dvwiebe/ADS1220RTD_Brewno_V2_Hardware/README.md

# ADS1220RTD_Brewno_V2_Hardware
RTD Shield Hardware
All the files you need to build your own shield.  The Gerber Files and Excellon drill file included to allow you to go straight
to fabrication.  Alternatively the Eagle files are available.
