dvwiebe/ADS1220RTD_Brewno_V2_Hardware/ADS1220RTD_BREWNO_V2_BOM.xlsx

 | Part
PCB Label | Qty | Device Description | Package | Value | Part# | Unit Cost | Extended Cost | Comments
ADS1220 | 1 | ADS1220 Temperature IC | TSSOP16 |  | ADS1220IPW | $14.65 | $14.65
PIC16F18345 | 1 | PDIP20 SOCKET | DIL20 |  | 4820-3004-CP | $0.88 | $0.88
ICSP | 1 | PINHD-1X5 | 1X05 |  | 22284101 | $0.55 | $0.55
DIGITAL8_13 | 1 | Pin Header 0.1" Pitch, 0.32" Mating Length | 1X10 |  | 22284101 | $0.74 | $0.74 | Optional if you cannot find Arduino Male & Female Header Pins. These work find but you cannot stack additional shields and you cannot breadboard easily with the shield attached.
ANALOG0_5 | 1 | Pin Header 0.1" Pitch, 0.32" Mating Length | 1X06 |  | 22284121 | $0.89 | $0.89
DIGITAL0_7, POWER | 2 | Pin Header 0.1" Pitch, 0.32" Mating Length | 1X08 |  | 22284081 | $0.61 | $1.22
Arduino Header Pin Set | 1 | Set of Arduino Header Pins w/ Male and Female Ends |  |  | PRT-11417 | $2.16 | $2.16 | Preferred. These can sometimes be harder to find but allow stacking of multiple shields
C2_5V, C3_5V, C4_5V, C15V | 4 | CAPACITOR- X7R or better | C0603 | 0.1uF | GRM188R71C104JA01D | $0.16 | $0.64
R1_5V | 1 | RESISTOR - 25ppm/C or better | R0603 | 10 ohms | RT0603DRD0710RL | $0.18 | $0.18
R1MCLR, R1_SW, R2_SW | 3 | RESISTOR | R0603 | 10Kohms | RC0603JR-0710KL | $0.02 | $0.06
C5_5V | 1 | CAPACITOR | C0603 | 10uF | GRM188R61A106ME69D | $0.26 | $0.26
RTD Terminals | 1 | SCREW TERMINAL |  |  | 1751345 | $9.31 | $9.31
RREF | 1 | RESISTOR - 10ppm/C or better | R0603 | 2.49Kohms | TNPU06032K49BZEN00 | $3.60 | $3.60
R1I2C, R2I2C | 2 | RESISTOR | R0603 | 4.7Kohms | RC0603JR-074K7L | $0.02 | $0.04
RF3, RF4 | 2 | RESISTOR - 25ppm/C or better | R0603 | 4.7kohms | AT0603DRD074K7L | $0.20 | $0.40
CCM1, CCM2, CCM3, CCM4 | 4 | C-EUC0603 | C0603 | 4.7nF | C0603C472J5GACTU | $0.45 | $1.80
R1SPI, R2SPI, R3SPI, R4SPI, R5SPI | 5 | RESISTOR | R0603 | 47 ohms | RC0603JR-0747RL | $0.02 | $0.10
RF1, RF2 | 2 | RESISTOR - 25ppm/C or better | R0603 | 5.9Kohms | RT0603DRD075K9L | $0.34 | $0.68
CDIF1, CDIF2 | 2 | RESISTOR - C0G/NPO | C1206 | 51nF | GRM31M5C1H513JA01L | $0.98 | $1.96
MAX4618CSE | 1 | IC SWITCH | SO16 |  | MAX4618CSE | $2.47 | $2.47
PIC16F18345 | 1 | PIC MICROCONTROLLER | PDIP20 |  | PIC16F18345-I/P | $2.01 | $2.01
 |  |  |  |  |  | Total | $41.75
