dvwiebe/ADS1220RTD_Brewno_V2_Hardware/ADS1220RTD_BREWNO_V2.brd

## EAGLE design ADS1220RTD_BREWNO_V2.brd (2016-12-25)

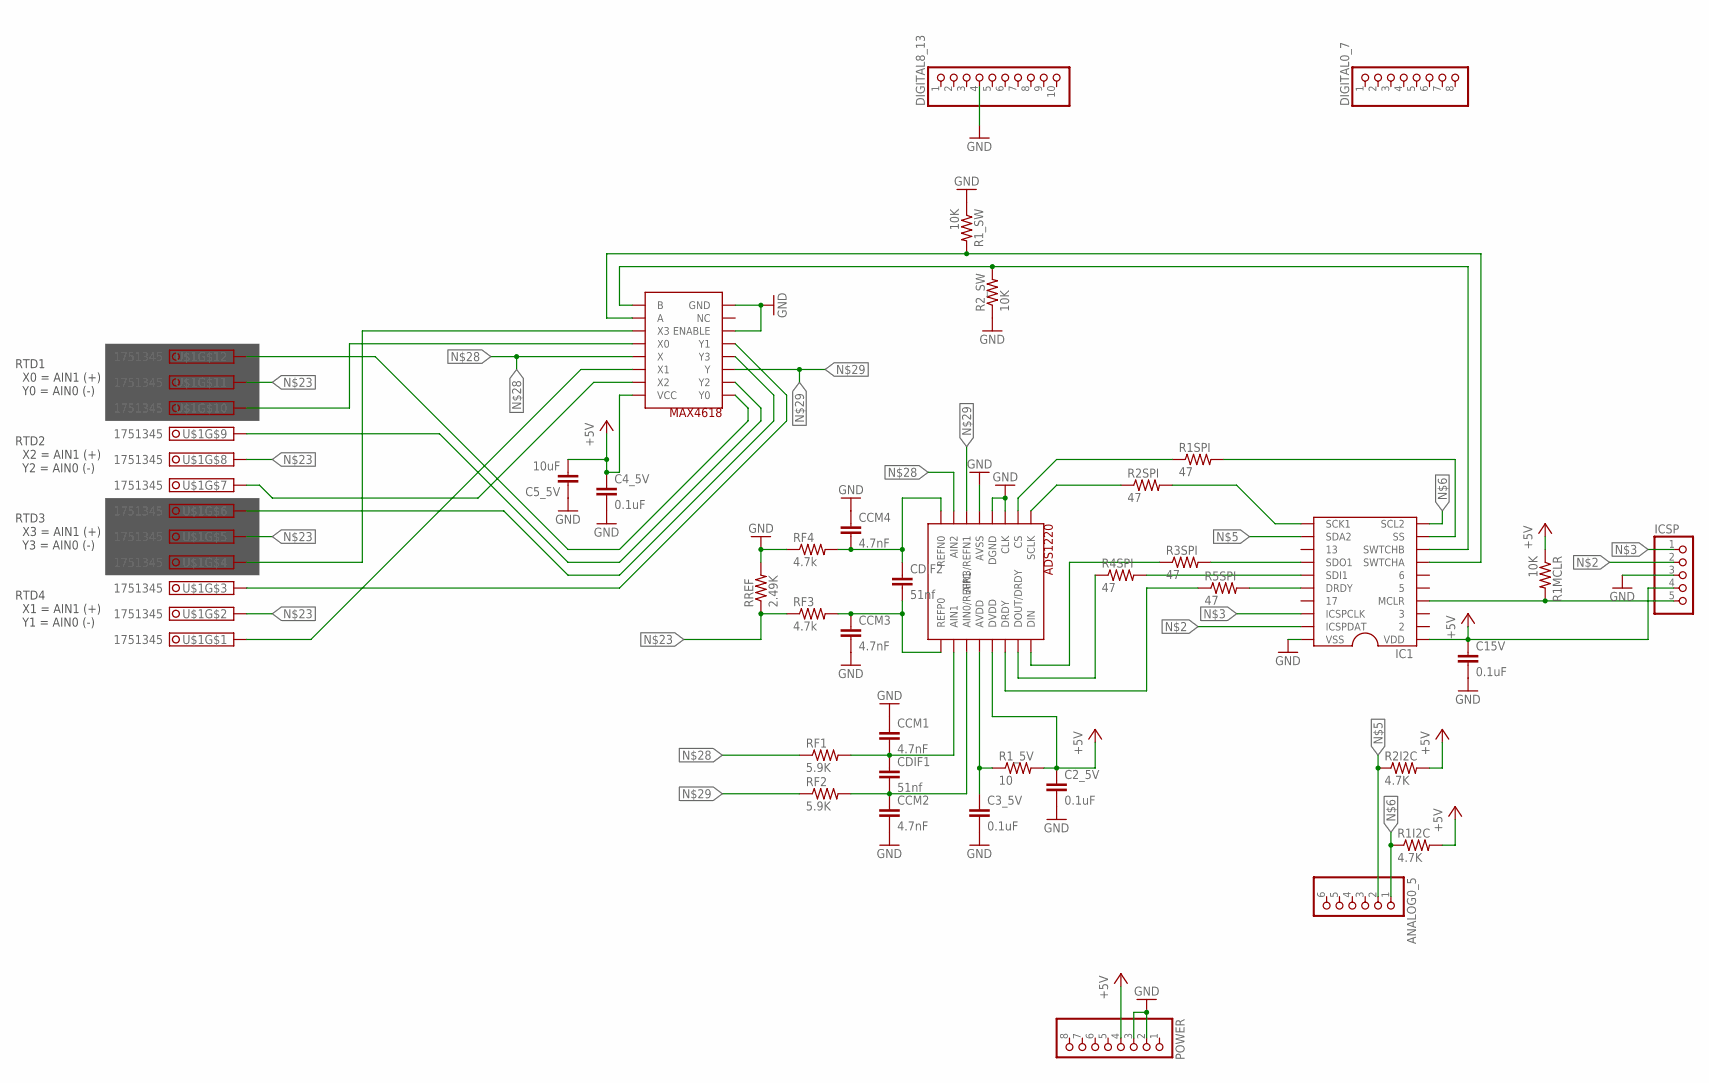
[picture p1: schematic ADS1220RTD_BREWNO_V2.sch]

Parts:
ADS1220: ADS1220; TSSOP16
ANALOG0_5: PINHD-1X6; 1X06
C2_5V, C3_5V, C4_5V, C15V: 0.1uF; C0603
C5_5V: 10uF; C0603
CCM1, CCM2, CCM3, CCM4: 4.7nF; C0603
CDIF1, CDIF2: 51nf; C1206
DIGITAL0_7: PINHD-1X8; 1X08
DIGITAL8_13: PINHD-1X10; 1X10
IC1: DIL20
ICSP: PINHD-1X5; 1X05
MAX4618: MAX4618CPE; SO16
POWER: PINHD-1X8; 1X08
R1I2C, R2I2C: 4.7K; R0603
R1MCLR, R1_SW, R2_SW: 10K; R0603
R1SPI, R2SPI, R3SPI, R4SPI, R5SPI: 47; R0603
R1_5V: 10; R0603
RF1, RF2: 5.9K; R0603
RF3, RF4: 4.7k; R0603
RREF: 2.49K; R0603
U$1: 1751345

Connections:
+5V: ADS1220.13 (DVDD), C2_5V.1, C4_5V.1, C5_5V.2, C15V.1, IC1.1 (VDD), ICSP.4, MAX4618.16 (VCC), POWER.4, R1I2C.2, R1MCLR.1, R1_5V.2, R2I2C.2
GND: ADS1220.3 (CLK), ADS1220.4 (DGND), ADS1220.5 (AVSS), C2_5V.2, C3_5V.2, C4_5V.2, C5_5V.1, C15V.2, CCM1.1, CCM2.2, CCM3.2, CCM4.1, DIGITAL8_13.4, IC1.20 (VSS), ICSP.3, MAX4618.6 (ENABLE), MAX4618.8 (GND), POWER.2, POWER.3, R1_SW.1, R2_SW.1, RF4.1, RREF.2
unnamed: IC1.4 (MCLR), ICSP.5, R1MCLR.2
unnamed: IC1.19 (ICSPDAT), ICSP.2
unnamed: IC1.18 (ICSPCLK), ICSP.1
unnamed: IC1.11 (SCK1), R2SPI.2
unnamed: ANALOG0_5.2, IC1.12 (SDA2), R2I2C.1
unnamed: ANALOG0_5.1, IC1.10 (SCL2), R1I2C.1
unnamed: ADS1220.1 (SCLK), R2SPI.1
unnamed: ADS1220.2 (CS), R1SPI.1
unnamed: IC1.9 (SS), R1SPI.2
unnamed: IC1.14 (SDO1), R3SPI.2
unnamed: IC1.15 (SDI1), R4SPI.2
unnamed: ADS1220.14 (DRDY), R5SPI.1
unnamed: ADS1220.12 (AVDD), C3_5V.1, R1_5V.1
unnamed: IC1.16 (DRDY), R5SPI.2
unnamed: ADS1220.16 (DIN), R3SPI.1
unnamed: ADS1220.15 (DOUT/DRDY), R4SPI.1
unnamed: IC1.8 (SWTCHB), MAX4618.9 (B), R2_SW.2
unnamed: IC1.7 (SWTCHA), MAX4618.10 (A), R1_SW.2
unnamed: ADS1220.8 (REFN0), CCM4.2, CDIF2.1, RF4.2
unnamed: ADS1220.9 (REFP0), CCM3.1, CDIF2.2, RF3.2
unnamed: RF3.1, RREF.1, U$1.2, U$1.5, U$1.8, U$1.11
unnamed: ADS1220.11 (AIN0/REFP1), CCM2.1, CDIF1.2, RF2.2
unnamed: ADS1220.10 (AIN1), CCM1.2, CDIF1.1, RF1.2
unnamed: ADS1220.7 (AIN2), MAX4618.13 (X), RF1.1
unnamed: ADS1220.6 (AIN3/REFN1), MAX4618.3 (Y), RF2.1
unnamed: MAX4618.1 (Y0), U$1.12
unnamed: MAX4618.12 (X0), U$1.10
unnamed: MAX4618.2 (Y2), U$1.9
unnamed: MAX4618.4 (Y3), U$1.6
unnamed: MAX4618.15 (X2), U$1.7
unnamed: MAX4618.5 (Y1), U$1.3
unnamed: MAX4618.14 (X1), U$1.1
unnamed: MAX4618.11 (X3), U$1.4

Notes on the sheet:
RTD4 X1 = AIN1 (+) Y1 = AIN0 (-)
RTD3 X3 = AIN1 (+) Y3 = AIN0 (-)
RTD2 X2 = AIN1 (+) Y2 = AIN0 (-)
RTD1 X0 = AIN1 (+) Y0 = AIN0 (-)

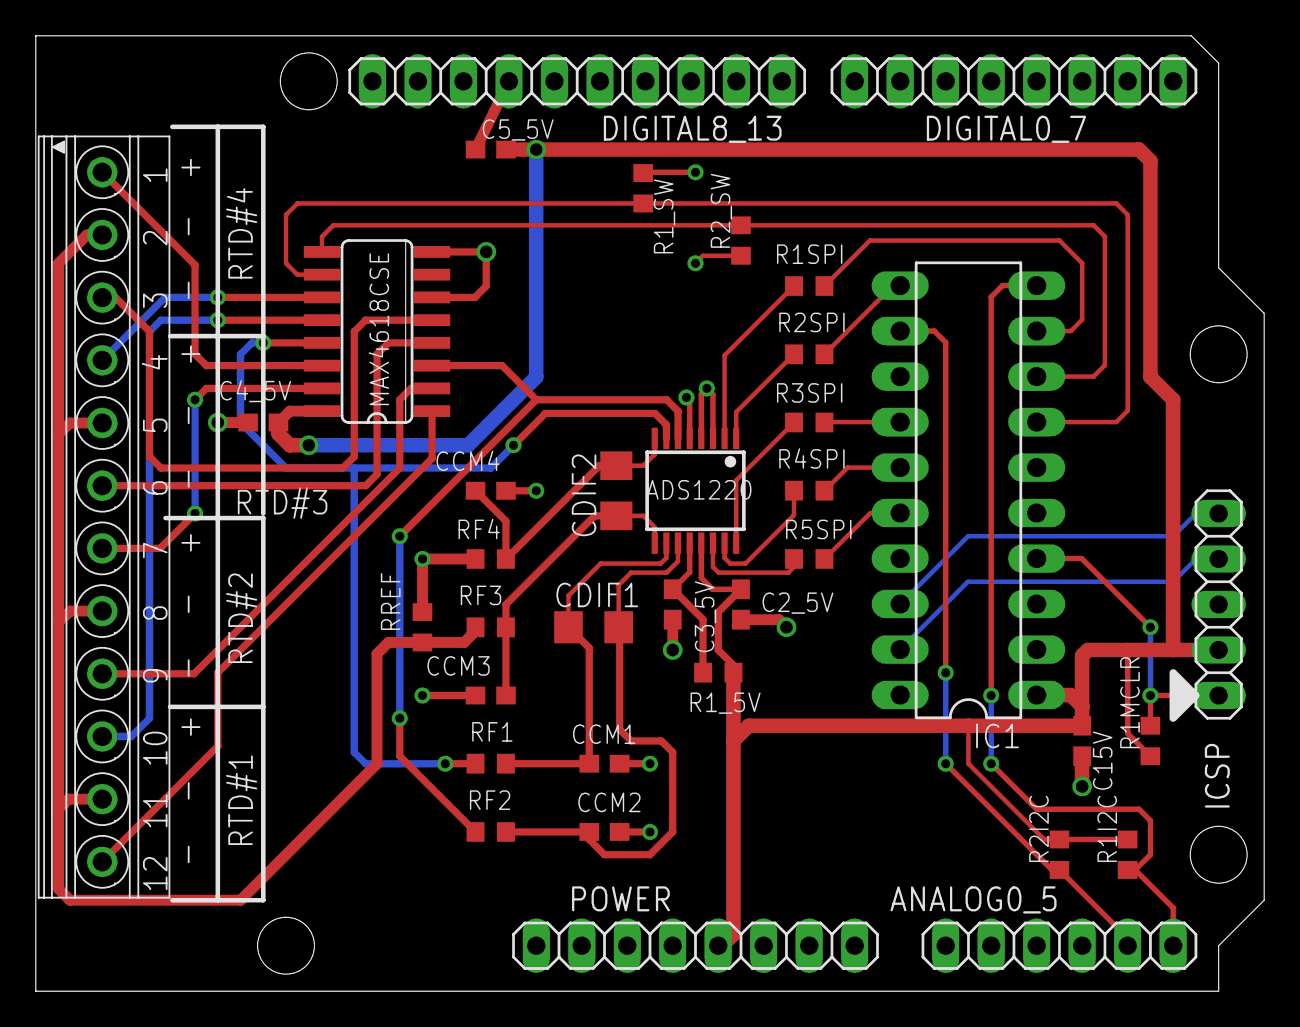
[picture p2: board ADS1220RTD_BREWNO_V2.brd from above]

Board: 2 copper layers, 68.6 x 53.3 mm, 36 parts (0 on the bottom side), 35 nets.
